hikmethankolay/Timur-RV32IMC/sw/runtime/include/timur_runtime.h

/**
 * @file timur_runtime.h
 * @brief Internal interface between the parts of the Timur C runtime.
 *
 * Shared by syscalls.c, uart.c, trap.c, vga.c and vga_font.c; programs
 * include timur.h instead. Declares the newlib system-call stubs (so that each
 * has one prototype), the linker-script symbols and the C trap entry point.
 */
#ifndef TIMUR_RUNTIME_H
#define TIMUR_RUNTIME_H

#include <stddef.h>
#include <sys/stat.h>

#include "timur.h"

/* ---- Symbols of linker.ld ------------------------------------------------------------- */
extern char _end[];       /**< first byte after .bss: the start of the heap */
extern char _heap_end[];  /**< end of the heap: the lowest address of the stack region */
extern char _stack_top[]; /**< initial stack pointer: the end of RAM */

/* ---- File descriptors of the console (<unistd.h> cannot be included: its
 *      prototypes of the stubs below differ from newlib's reentrant ones) ------------------ */
#define TIMUR_FD_STDIN  0
#define TIMUR_FD_STDOUT 1
#define TIMUR_FD_STDERR 2

/* ---- newlib system-call stubs (syscalls.c) ----------------------------------------------
 * The console is the UART: fd 0 is stdin, 1 and 2 are stdout and stderr. Errors
 * set errno and return -1, as newlib expects.                                     */
int _read(int fd, char *buf, int len);
int _write(int fd, const char *buf, int len);
void _exit(int code) __attribute__((noreturn));
void *_sbrk(ptrdiff_t increment);
int _close(int fd);
int _lseek(int fd, int offset, int whence);
int _fstat(int fd, struct stat *st);
int _isatty(int fd);
int _kill(int pid, int sig);
int _getpid(void);

/* ---- Console ------------------------------------------------------------------------------ */
/** Called by _write for every byte of stdout and stderr after the UART has sent it;
 *  vga_console_init sets it to vga_putc. NULL: the UART only. */
extern void (*timur_console_hook)(char c);

/* ---- VGA font (vga_font.c, generated by sw/gen_font.py) ------------------------------ */
#define VGA_FONT_FIRST  0x20 /**< the first character in the font */
#define VGA_FONT_GLYPHS 95   /**< 0x20-0x7E */
#define VGA_FONT_ROWS   8
/** Row r of character c is vga_font[c - VGA_FONT_FIRST][r]; bit 7 is the leftmost pixel. */
extern const uint8_t vga_font[VGA_FONT_GLYPHS][VGA_FONT_ROWS];

/* ---- Traps ---------------------------------------------------------------------------- */
/** Dispatch a trap (trap.c); called by trap_entry with the saved registers. */
void timur_trap(struct trap_frame *frame);

#endif /* TIMUR_RUNTIME_H */
