hikmethankolay/Timur-RV32IMC/(commit log)

2026-04-21 Add detailed README documentation
    Replace placeholder README with a comprehensive project README describing the Timur-RV32IMC soft-core: overview, architecture diagram, ISA support and phase status, module breakdown (primitives and execution datapath), AHB/APB bus address maps, pipeline and hazard handling, peripherals (GPIO, UART, DMAC), toolchain and build/simulation instructions, C software layer and example build steps, project roadmap, directory layout, and license. This provides full developer-facing documentation to guide development, simulation, synthesis, and software integration for the Intel FPGA target.
2026-04-21 Fix test vector file paths in testbenches
    Corrected incorrect "tb/tb/vectors/..." paths to "tb/vectors/..." in multiple testbenches so $fopen can locate the vector files during simulation. Files updated: tb/adder_32bit_tb.v, tb/alu_tb.v, tb/barrel_shifter_tb.v, tb/branch_condition_evaluator_tb.v, tb/d_ff_tb.v, tb/divider_tb.v, tb/multiplier_tb.v, tb/mux2_tb.v, and tb/mux4_tb.v. This prevents file-open errors and failing simulations.
    [adder_32bit_tb.v, alu_tb.v, barrel_shifter_tb.v, branch_condition_evaluator_tb.v, d_ff_tb.v, divider_tb.v, multiplier_tb.v, mux2_tb.v]
2026-04-21 Expand README with phases, modules and formatting
    Add detailed Phase 3–12 documentation and expand module listings across the README: PC, register file, ROM/RAM AHB slaves; decode/control/imm/parser; single-cycle integration; pipeline registers; hazard resolution and forwarding; APB peripherals (GPIO, UART, DMAC, ahb2apb bridge); AHB bus fabric (arbiter, masters, decoder); CSR regfile and C-extension decompressor; and the C software layer (linker, crt0, syscalls, bin2mif). Also reformat ASCII diagrams into fenced text blocks, tweak pipeline and bus wording/spacing, and ensure EOF newline. These changes improve roadmap clarity and document new RTL/software components added in later project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
2026-04-21 Normalize Markdown table separators in README
    Standardize the table divider rows in README.md by normalizing dash counts and spacing across multiple tables (ISA Support, Phase table, AHB/APB address maps, stall table, Tool Stack). This is a purely formatting change to improve consistency and Markdown rendering; no semantic content was modified.
2026-04-21 Add PC register module with testbench and vectors
    Add a 32-bit program counter module (rtl/memory/pc.v) that instantiates a parameterized d_ff to capture pc_next with clk, rst_n and en control signals and exposes the pc output. Introduce a Verilog testbench (tb/pc_tb.v) that reads tb/vectors/pc_vectors.txt and verifies async reset, enable-hold, clocked capture, sequential increments and jump behavior; the testbench reports pass/fail counts. The vectors file documents test cases and the check type (async vs clocked).
    [pc.v, pc_tb.v]
2026-04-21 Add AHB ROM, testbench, and memory init files
    Introduce a read-only AHB ROM peripheral and associated test infrastructure. Adds rtl/memory/rom_ahb.v (AHB slave ROM with 1Kx32 storage, addr register, ram_init attribute and $readmemh), rom.mif and ram.mif memory initialization files, a directed testbench tb/rom_ahb_tb.v, and test vector file tb/vectors/rom_ahb_vectors.txt. Also updates Quartus project files (Timur_RV32IMC.qsf and .tcl) to include the new RTL and testbench files and to add partition-related assignments. The ROM test program (rom.mif) contains sample instructions to exercise arithmetic, logic, memory, branch and multiply paths; the testbench stamps known words into ROM and verif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
2026-04-22 README: rename modules and expand simulation
    Update documentation to reflect renamed RTL modules and to provide a clearer, automated simulation workflow. Renamed references: dff -> d_ff, pll_wrapper -> cpu_pll (notes cpu_pll_bb.v black-box), adder -> adder_32bit, branch_eval -> branch_condition_evaluator, and register_file -> registers. Reworked Simulation section to describe ModelSim-Intel prerequisites, introduce run_tests.bat and the regression TCL flow, show a concise vsim/vlog example for manual runs, and document testbench conventions (vector files, total/failed counters, PASSED/FAILED output and a small settle delay for combinational checks). These changes align README text with the r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
2026-04-23 Add AHB RAM and testbench; expand ROM
    Add a new ram_ahb module (single-cycle AHB RAM) implementing address registration, byte/half/word byte-enable writes, sign/zero-extended reads, and initialization attribute for a RAM init file. Add ram_ahb_tb.v with comprehensive read/write tests (byte/half/word, LB/LBU/LH/LHU, HSEL/HTRANS behavior, async reset cases) to validate the RAM. Update rom_ahb.v to increase memory depth from 1024 to 16384 entries and change address indexing (addr_reg[11:2] -> addr_reg[15:2]) so ROM/ram use the same 16-bit word index, and adjust the initialization loop accordingly.
    [ram_ahb.v, ram_ahb_tb.v, rom_ahb.v]
2026-04-23 Tidy README and initialize ROM with NOPs
    Escape ampersand in README headings, expand the Simulation TOC with subsections (prereqs, running tests, single testbench, conventions), and mark Phase 3 as completed. In rtl/memory/rom_ahb.v initialize ROM contents to 32'h00000013 (NOP) in the initial loop and remove the $readmemh("rom.hex", mem) dependency to avoid relying on an external hex file during startup.
    [rom_ahb.v]
2026-04-23 Mark state & memory as complete in README
    Update the project roadmap in README.md: mark item 3 (State & memory — PC, Register File, ROM AHB slave, RAM AHB slave) as complete and tweak item 4's status label to '🔜 Next' for clarity.
2026-04-24 Add imm_gen immediate generator and tests
    Introduce imm_gen Verilog module that extracts and assembles 32-bit immediates for RISC-V instruction formats (I, S, B, U, J and SYSTEM), including sign-extension and zero-extension for CSR uimm. Add a regression testbench imm_gen_tb.v and a vectors file imm_gen_vectors.txt covering ALU-imm, loads, stores, branches, LUI/AUIPC, JAL/JALR and SYSTEM cases to validate sign-extension and bit-field recombination. This provides a standalone immediate-generation unit and automated vectors to catch encoding/layout issues.
    [imm_gen.v, imm_gen_tb.v]
2026-04-24 Implement SLTU and refactor ALU control mapping
    Add SLTU support and tidy up ALU internals: include SLTU in do_sub logic, add sltu_result = {31'b0, ~adder_cout}, and add an explicit case for 5'b01100 in the result mux. Reformat and group wire/reg declarations, annotate ALUControl cases with operation comments, and normalize spacing/formatting. Also changed the barrel shifter default shift_type from 2'b11 to 2'b00 (was previously the default), and made minor stylistic changes to instantiation and signal declarations. These changes implement unsigned less-than and improve readability/maintainability of the ALU module.
2026-04-24 Add SLTU and DIV/REM cases to ALU vectors
    Expand and reorganize ALU test vectors: update header/format comments, add ALUControl entries for SLTU (12) and DIV/DIVU/REM/REMU (20-23), and include new test rows covering unsigned comparisons, boundary cases, M-extension (mul) examples, division/remainder semantics, div-by-zero and signed overflow cases. Clarify adder behavior and mark SLT as signed; reorganize sections for readability and add more edge-case coverage.
2026-04-24 Add CPU datapath and module wiring to top
    Populate top-level Timur_RV32IMC with CPU datapath wiring and module instantiations. Adds PC, ROM AHB fetch, instruction parser, immediate generator, main control unit, ALU decoder, register file, ALU, branch evaluator, RAM AHB data memory, muxes and adders, plus AHB bus signals and HSEL logic. Includes temporary placeholders for enable/HTRANS/div_start and wires up pc_next selection (pc+4 vs branch target) and memory-to-register writeback.
2026-04-24 Update QSF, remove memory inits, fix top ports
    Set project TOP_LEVEL_ENTITY to Timur_RV32IMC and add multiple VERILOG_FILE entries and partition assignment in the .qsf. Remove initial-block memory zeroing from ram_ahb.v and rom_ahb.v so memories rely on their .mif initialization. Adjust top-level instance wiring in Timur_RV32IMC.v: rename register instance ports (rd_addr->rd, rd_data->reg_write_data) to match module interface and connect RegWrite accordingly, and pass rst_n into the alu. Also minor formatting/spacing fixes.
    [Timur_RV32IMC.v, ram_ahb.v, rom_ahb.v]
2026-04-24 Add MIF files & fix divider counter width
    QSF: add partition hierarchy instance assignment, include ROM/RAM MIF files, and add SOURCE_FILE db/Timur_RV32IMC.cmp.rdb. Divider: make bit_counter references explicit 6-bit literals (6'd31, 6'd0, 6'd1), ensure remainder_reg is updated in both branches, and clean up alignment/formatting. These changes prevent width/typing issues in the divider state machine and add required memory initialization files to the project file.
    [divider.v]
2026-04-24 Split datapath into module, add PLL and SDC
    Refactor top-level: move CPU datapath logic from rtl/top/Timur_RV32IMC.v into a new rtl/top/datapath.v module and simplify the top module to a wrapper that instantiates cpu_pll and the datapath (holds CPU in reset until PLL locks, exposes pc_out).
    Add timing constraints: new Timur_RV32IMC.sdc creates a 50 MHz clock, derives PLL clocks and applies standard clock uncertainty, and update the .qsf to reference the SDC and the new datapath.v file (and adjust instance/assignment ordering).
    Memory image updates: enlarge rom.mif and ram.mif to 16384 words (64 KB), initialize RAM to zeros across the full range and set ROM to NOP-filled default (previous t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
    [Timur_RV32IMC.v, datapath.v]
2026-04-24 Use byte-wide RAM banks and support byte writes
    Replace single 32-bit memory array with four 8-bit banks (mem0..mem3) and update write/read logic to perform per-byte writes using byte_enable and reconstruct 32-bit words from the byte arrays. Removed the ram_init_file attribute and made minor formatting/style cleanups. This change enables proper byte-enable writes (and may improve synthesis for byte-granular RAM accesses) while preserving existing read sign/zero-extension behavior.
    [ram_ahb.v]
2026-04-25 Fix AHB data-phase timing and add testbench
    Ensure AHB-lite timing and add simulation/testbench updates:
    - rtl/memory/ram_ahb.v: Tighten HADDR/HWRITE update to only occur when 'active' is asserted; set hsel_reg to 1 only during active and 0 otherwise. This avoids spurious selections outside an active transfer.
    - rtl/top/datapath.v: Register write-data (rs2_data) into hwdata_d and drive HWDATA from that register so write data is valid in the AHB data phase. Use pc_next for ROM HADDR/HSEL so address register matches PC after the posedge.
    - run_tests.tcl: Exclude black-box stubs and the Altera PLL megafunction from the automatic RTL glob, explicitly add the simulation-safe cpu_pll_bb.v stub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
    [datapath.v, ram_ahb.v]
2026-04-25 Fix LUI handling and bus HREADY multiplexing
    Set ALUOp to ADD for the LUI path and adjust datapath so LUI produces imm: add an AUIPC premux (pc as ALU A) and a LUI mux that forces ALU A = 0. Split HREADY into HREADY_ROM/HREADY_RAM and mux into a single HREADY based on HSEL to route per-slave ready signals. Update test vectors to reflect the corrected LUI control signals.
    [datapath.v, main_control_unit.v]
2026-04-25 Refactor datapath into pipeline stages
    Split the monolithic datapath into separate pipeline stage modules (if_stage, id_stage, ex_stage, mem_stage, wb_stage). Extracted instruction fetch, decode, execute, memory and writeback logic into rtl/top/*.v, moved ROM/RAM AHB handling into if_stage/mem_stage, and rewired pc_current/pc_plus4/pc_next, instruction, and reg-write paths between stages. The main control and ALU decoder remain in datapath while the dataflow and ALU/branch/PC logic were relocated to the new stage modules to improve modularity and prepare for further pipeline enhancements.
2026-04-26 Register new Verilog files and sync ram_ahb read
    Add multiple VERILOG_FILE entries to the Quartus project (.qsf and .tcl) to include testbenches and top-level RTL (wb/mem/if/id/ex stages, datapath, decode blocks, ram_ahb, etc.) and add a SOURCE_FILE DB entry; remove TOP_LEVEL_ENTITY 'alu' in the Tcl assignments. Modify rtl/memory/ram_ahb.v to replace the combinational 32-bit 'word' wire with a registered 'word' updated on HCLK when active and using HADDR for indexing, making RAM reads synchronous to the clock (avoids combinational-read timing/glitch issues).
    [ram_ahb.v]
2026-04-26 Use addr_reg word in RAM; fix TB reg path
    Replace the clocked 32-bit 'word' register in rtl/memory/ram_ahb.v with a combinational wire assembled from mem3..mem0 indexed by addr_reg[15:2], removing dependence on HADDR/active and simplifying byte selection. Update tb/Timur_RV32IMC_tb.v to reference the new register-file path (dut.cpu.decode.register_file.regs[]) instead of the old dut.cpu.register_memory.regs[] in both the runtime display and final checks.
    [ram_ahb.v]
2026-04-26 Use registered word in ram_ahb
    Assemble the 32-bit word from mem0..mem3 into a clocked register (word_reg) on the HCLK rising edge instead of a combinational wire. Update byte/half selection and hrdata cases to use word_reg. This makes memory reads synchronous and reduces combinational paths through the memory outputs.
2026-04-26 Add pipeline registers & refactor datapath
    Introduce explicit pipeline register modules (if_id_reg, id_ex_reg, ex_mem_reg, mem_wb_reg) and wire them into the datapath to implement IF/ID, ID/EX, EX/MEM and MEM/WB stages. Refactor datapath.v to use the new inter-stage signals, adjust stage interfaces (ex_stage now exposes jump/branch targets and redirect signal, if_stage provides pc_instr), and add a PC selection mux for next PC. Fix AHB memory slaves: ram_ahb byte/halfword byte-enable and read formatting were corrected and HRDATA is now gated; rom_ahb had minor cleanup and addr_reg placement adjusted. Update if_stage timing (pc_instr register) and adapt the testbench to observe the new IF sig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
    [datapath.v, ex_mem_reg.v, ex_stage.v, id_ex_reg.v, if_id_reg.v, mem_wb_reg.v, ram_ahb.v, rom_ahb.v]
2026-04-26 Update AHB RAM, pipeline regs, and project files
    Add pipeline register sources to project files and remove the Quartus workspace; update generated Tcl timestamp. In rtl/memory/ram_ahb.v: constrain RAM arrays to M10K, simplify and correct address/byte-enable logic, move to synchronous byte reads, use HADDR for current-phase accesses, and always drive HRDATA/HREADY/HRESP (improves timing/resource mapping and read/write behavior). In rtl/pipeline/id_ex_reg.v and rtl/pipeline/ex_mem_reg.v: separate reset and flush handling so reset explicitly zeroes all outputs and flush still clears pipeline registers, making reset semantics explicit and safer.
    [ex_mem_reg.v, id_ex_reg.v, ram_ahb.v]
2026-04-26 Pipeline AHB RAM/ROM and CPU LSU formatting
    Introduce cycle-accurate address/data-phase handling for AHB memories and move LSU formatting into the CPU. Key changes:
    - Project files: enable TIMING_ANALYZER_MULTICORNER_ANALYSIS and set NUM_PARALLEL_PROCESSORS=16 in .qsf/.tcl.
    - ram_ahb.v: switch to block/romstyle attributes, add address-phase latching, byte-enable generation function, synchronous write port using latched signals, and synchronous read pipeline returning aligned 32-bit words on the data phase.
    - rom_ahb.v: infer initialized block ROM, pipeline reads so HRDATA is the aligned 32-bit word available in the data phase.
    - mem_stage.v: capture addr LSB and funct3 in address phase and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
2026-04-26 Add stall support and IF-stage flush handling
    Introduce a stall input to the datapath and wire it from the top module (currently tied low). Propagate stall to IF/ID and ID/EX pipeline registers (use ~stall for their enable). Add pc_en and if_flush ports to if_stage so the PC can be frozen on stall and pc_instr can be flushed on branch redirects. Implement a pc_instr pipeline register that is cleared on if_flush and frozen when pc_en is low to match AHB ROM latency. Add a one-cycle delayed ex_pc_redirect_d signal and widen IF/ID flush to ex_pc_redirect | ex_pc_redirect_d to ensure correct pipeline flushing on branch redirects.
    [Timur_RV32IMC.v, datapath.v]
2026-04-26 Mark Phase 6 pipeline as complete in README
    Update project status to reflect completion of Phase 6 (5-stage pipeline registers). Adjust the status table and progress-summary lines to mark Phase 6 as ✅ Complete and move the "Next" indicator to Phase 7. This change only updates README documentation.
2026-04-27 Add forwarding and hazard units and tests
    Introduce data-forwarding and hazard detection to handle pipeline hazards and AHB bus stalls. Added new modules rtl/hazard/forwarding_unit.v and rtl/hazard/hazard_detection_unit.v and wired them into the datapath: datapath.v now instantiates forwarding_unit and hazard_detection_unit, connects HREADY signals, and uses a branch_flush signal for pipeline flushes. ex_stage.v updated to support forwarding muxes, divider start/inflight handling, refined ALU operand selection (LUI/AUIPC/JAL/JALR), and produce correct jump/branch outputs. main_control_unit.v updated to set Branch for JAL/JALR. if_stage.v and mem_stage.v updated for HREADY signals. Testbench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
    [Timur_RV32IMC.v, asm.py, datapath.v, ex_stage.v, forwarding_unit.v, forwarding_unit_tb.v, hazard_detection_unit.v, hazard_detection_unit_tb.v]
2026-04-27 Fix ALU decode, hazards and pipeline stall logic
    Multiple fixes to pipeline control, ALU decoding and testbench:
    - alu_decoder: accept opcode and only use funct7 for R-type and I-shift forms (prevents funct7 bits from leaking into I-arith like ADDI). Adjusted control logic accordingly.
    - Testbench/vectors: updated alu_decoder_tb and vector file to include opcode in vectors and cover I-arith cases.
    - registers: add write-back bypass so reads in the same cycle return rd_data when appropriate (fix RAW timing).
    - hazard_detection_unit: split stall into bubble_stall (load-use, bus-wait) and freeze_stall (multi-cycle EX like DIV); provide aggregate stall signal.
    - datapath: propagate new stall cl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
    [alu_decoder.v, alu_decoder_tb.v, datapath.v, ex_mem_reg.v, ex_stage.v, hazard_detection_unit.v, mem_wb_reg.v, registers.v]
2026-04-27 Remove tools/asm.py and tools/test_program.py
    Delete the tiny RV32IM encoder (tools/asm.py) and the test ROM generator (tools/test_program.py) used to build test_rom.hex and print expected testbench state. These files appear to be obsolete or relocated, so the testbench assembly generator and example program were removed to clean up the repository.
2026-04-27 ram_ahb write-forwarding; remove mem_read_data
    Add write-forwarding to ram_ahb so a synchronous read in the same cycle as a write returns the newly written bytes (per-byte via write_be). Remove the mem_read_data signal from the MEM/WB pipeline register because the AHB-Lite RAM has a 1-cycle synchronous read whose internal flop naturally forms the MEM/WB boundary; mem_read_data is fed directly from the MEM-stage RAM into WB. Update datapath to stop threading load data through mem_wb_reg and wire mem_read_data into the WB stage. Also make ROM HTRANS driven by pc_en in if_stage. Add explanatory comments in mem_wb_reg and datapath about the synchronous-read behavior.
2026-04-27 Migrate to SystemVerilog and add pipeline_pkg
    Add pipeline_pkg.sv (id_decoded_t) and refactor ID/IF stages into SystemVerilog modules. Rename several top modules from .v to .sv (datapath, ex_stage, mem_stage, wb_stage, Timur_RV32IMC) and replace id_stage.v/if_stage.v with fuller SystemVerilog implementations that pack/unpack the new id_decoded_t bundle. Update datapath to import the package, use the bundled ID outputs, adjust branch/flush signaling and forwarding interfaces, and move pc_plus4 calculation into ex_stage. Update run_tests.tcl to compile .sv files, enable -sv, add +incdir for packages, hoist the package file to compile first, and include the cpu_pll stub. Minor cleanup: remove o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
    [datapath.sv, mem_wb_reg.v]
2026-04-27 Update README target FPGA to DE10-Lite
    Replace references to the DE1-SoC (Cyclone V) with the Terasic DE10-Lite (Intel MAX 10 10M50DAF484C7G, 50K LEs) in the README's target FPGA and supported board list. Note that Quartus Prime remains the synthesis tool.
2026-04-27 Update Quartus project and AHB RAM/ROM RTL
    Add and reorganize project file entries (QSF/TCL): enable multicorner timing, increase parallel workers, and register many new VERILOG/SYSTEMVERILOG and testbench files (reorder/remove duplicates). Update ram_ahb.v to target M9K block RAMs, restructure synchronous read/write logic, add per-byte synchronous writes and a read-after-write bypass path so read data reflects recent writes, and rename internal read signal. Update rom_ahb.v attribute to infer M9K RAMs (replace romstyle/ram_init hint) while keeping existing initialization via $readmemh. Also update generated Tcl timestamp.
    [ram_ahb.v, rom_ahb.v]
2026-04-27 Simplify multiplier logic and use DSP
    Replace multiple sign/unsigned extensions and product wires plus a mux with a single signed multiply. Add a_is_signed and b_is_signed signals to compute 33-bit extended operands, use a single (* multstyle = "dsp" *) product, and select either the low 32 bits for MUL or the high 32 bits for MULH variants. This reduces duplicated logic, removes the external mux4 instance, and guides synthesis to use DSP resources.
    [multiplier.v]
2026-04-28 Add 2-cycle pipelined multiplier and integrate MUL
    Introduce a 2-cycle pipelined multiplier module and wire MUL support through the datapath and hazard logic. The multiplier registers DSP inputs, produces a busy/done handshake, and returns 32-bit results; alu, ex_stage and hazard_detection_unit were extended to support mul_start/mul_busy/mul_done and to prevent restarts while a MUL is inflight. ID stage now precomputes PC+4 and branch target (moved out of EX) and the ID/EX register carries these values. registers.v was changed to write on negedge and provide combinational reads (x0 hardwired), removing previous bypass muxes. wb_stage simplified memory-to-reg selection to use alu_result direc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
    [alu.v, alu_tb.v, datapath.sv, hazard_detection_unit.v, hazard_detection_unit_tb.v, id_ex_reg.v, multiplier.v, multiplier_tb.v]
2026-04-28 Set board clk period to 25 ns
    Update SDC to use a 25 ns clock period by changing create_clock from 20.000 to 25 and updating the inline comment. This adjusts the implied oscillator from 50 MHz (20 ns) to 40 MHz (25 ns); derive_pll_clocks is unchanged.
2026-04-29 Clean up comments in execution RTL
    Remove and simplify non-functional comments in the execution stage sources: shorten the SLTU comment in rtl/execution/alu.v and delete the large header comment block in rtl/execution/multiplier.v. These are documentation-only edits and do not change logic or behavior.
    [alu.v, multiplier.v]
2026-04-29 Refactor branch/jump handling and cleanups
    Simplify and consolidate branch/jump logic across IF/ID/EX and datapath, remove unused signals and extraneous comments. Key changes:
    - ex_stage: remove Branch input, introduce OPC_BRANCH and is_cond_branch/is_uncond_jump signals; simplify ALU A selection (replace mux with combinational assign); evaluate conditional branches into cond_branch_taken and compute redirect_pc (JALR vs B/JAL); emit branch_target_out and BranchTaken_out from EX based on masked conditional branch or unconditional jumps; remove jump_target wire and related mux.
    - datapath: drop unused ex_jump_target and related ports; remove various explanatory comments and dead wiring; pass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
    [datapath.sv]
2026-04-29 Refactor pipeline regs and decode bus names
    Rework pipeline package and pipeline registers to a clearer, gated/flushable interface for multicycle backend support. Renamed id_decoded_t → dec_bus_t and many fields (opcode→opc7, rd→rd_idx, rs1/rs2→rs1_idx/rs2_idx, imm→imm32, ALUControl→alu_ctrl5, ALUSrc→alu_use_imm, etc.). Updated IF/ID, ID/EX, EX/MEM and MEM/WB modules to use gate_i/flush_i semantics, new signal suffixes (_d/_x/_m/_w), and added control signals (wb_from_ld, rf_we, br_jmp, csr/trap fields). Top-level and datapath were adjusted for new clock/PLL naming, PC debug export, and the revamped pipeline interfaces; forwarding and hazard units were re-wired to the new signa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
    [datapath.sv, ex_mem_reg.v, id_ex_reg.v, if_id_reg.v, mem_wb_reg.v]
2026-04-29 Fix board clock port/name and comment
    Update SDC to match the top-level RTL: change the create_clock name from {clk} to {clk_board} and the port from {clk} to {clk_i}. Also correct the file comment to state 40 MHz (25 ns period) and make the period explicit as 25.0. This ensures the SDC clock declaration matches Timur_RV32IMC.sv and fixes the previous misleading frequency comment.
2026-04-29 Make multiplier combinational single-cycle
    Replace the 2-cycle/pipelined multiplier with a single-cycle combinational implementation and remove associated control signals. The multiplier now sign/zero-extends operands to 33 bits, uses a combinational DSP-style product, and directly drives the 32-bit result (MUL selects low 32, MULH/MULHSU/MULHU select high 32). ALU and EX-stage interfaces were simplified by removing mul_start/mul_busy/mul_done, and hazard detection/datapath were updated to treat MUL as a single-cycle op (only DIV remains multi-cycle). Testbenches for ALU, multiplier, and the hazard unit were adjusted to remove start/busy/done sequencing for MUL and to use the single-cycle be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
    [alu.v, alu_tb.v, datapath.sv, hazard_detection_unit.v, hazard_detection_unit_tb.v, multiplier.v, multiplier_tb.v]
2026-04-29 Add APB GPIO peripheral module
    Add rtl/peripherals/gpio_apb.v implementing a simple APB slave GPIO peripheral and remove .gitkeep. The module provides 32-bit GPIO OUT (0x00), IN (0x04) and DIR (0x08) registers, with OUT/DIR writable via APB (PSEL/PENABLE/PWRITE) and IN sampled through a two-stage synchronizer to avoid metastability. PREADY is tied high and PSLVERR low; reset clears registers to zero. No byte-enable or wait-state support is implemented in this basic peripheral.
    [gpio_apb.v]
2026-04-30 Add DE10-Lite pinout and clock updates
    Add Terasic DE10-Lite board pin assignments and SDC clock setup, update top-level ports to use board clocks, and adapt testbench. QSF: reference SDC, device filter and large set of IO location/IO_STANDARD assignments generated by System Builder. SDC: create board clocks (10 MHz and two 50 MHz) and placeholders for derived/uncertainty constraints. rtl/top/Timur_RV32IMC.sv: replace single clk port with ADC_CLK_10, MAX10_CLK1_50 and MAX10_CLK2_50 and feed PLL from MAX10_CLK1_50. tb/Timur_RV32IMC_tb.v: add clk_50/clk_10, toggle matching periods, force PLL locked and cpu clock from 50 MHz, and update DUT port connections to match the new top ports. These cha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
2026-04-30 Revert "Make multiplier combinational single-cycle"
    This reverts commit 6d274d9fe834fa853eb9d34bcd238e47f1628827.
    [alu.v, alu_tb.v, datapath.sv, hazard_detection_unit.v, hazard_detection_unit_tb.v, multiplier.v, multiplier_tb.v]
2026-04-30 Add adder_zero signal from ALU
    Introduce a new adder_zero output from the ALU that reflects whether the adder output == 0, distinct from the full muxed ALU result zero. Propagate this signal through ex_stage (added adder_zero_w and connected it to the branch_condition_evaluator) and update the ALU testbench to include the new port. This avoids using the wide muxed result for branch comparisons (BEQ/BNE) and keeps branch logic tied to the adder output.
    [alu.v, alu_tb.v]
2026-04-30 Compute aligned JALR target via adder
    Instantiate a dedicated 32-bit adder to compute rs1 + imm for JALR, generate jalr_sum_w and jalr_pc_w (LSB forced to 0), and wire unused cout/overflow outputs to avoid warnings. Replace the previous use of alu_raw_w for JALR jump target with jalr_pc_w so jmp_pc_w is correctly aligned. Changes in rtl/top/ex_stage.sv.
2026-04-30 Add ALU-A ID-side operand for AUIPC/LUI
    Propagate an ID-side ALU-A operand so LUI/AUIPC can use a precomputed A input. Added alu_a_use_id and alu_a_id to pipeline_pkg, latched them in id_ex_reg, and wired them through datapath to the EX stage. id_stage now accepts pc_d_i and sets dec_bus.alu_a_use_id/alu_a_id (AUIPC uses PC, LUI uses 0). ex_stage signature updated to consume the new signals and removed the now-unused pc_x_i port. Files changed: rtl/include/pipeline_pkg.sv, rtl/pipeline/id_ex_reg.v, rtl/top/datapath.sv, rtl/top/ex_stage.sv, rtl/top/id_stage.sv.
2026-04-30 Split barrel_shifter into SLL/SRL/SRA paths
    Refactor barrel_shifter to implement three separate 32-bit logarithmic shift trees (SLL, SRL, SRA) with per-stage 2:1 muxes, and a final 4:1 type mux to select the shift type or bypass to the original input. Preserves arithmetic right-shift sign extension from the original input MSB (matching prior behavior), and maintains the bypass behavior for shift_type == 2'b11. This clarifies the shift logic and removes the previous per-stage type multiplexing.
2026-04-30 Mark Phase 7 complete; clarify hazard handling
    Update README to mark Phase 7 as complete and move Phase 8 to “next”. Expand the Hazard Detection Unit docs to describe multi-cycle ALU ops (div/mul), introduce bubble_stall vs freeze_stall semantics, and add mul_busy handling. Clarify that branch/jump redirect is committed in MEM (br_jmp ∧ br_taken) and adjust the hazard table and pipeline behavior explanations accordingly.
2026-05-01 Add UART APB peripheral and testbench
    Introduce a simple UART APB peripheral and supporting RTL: uart_apb, uart_apb_regs, uart_baud_gen, uart_tx and uart_rx. Add a loopback testbench (tb/uart_apb_tb.v) that configures a baud divisor and verifies TX->RX loopback for values 0x41, 0x00 and 0xFF. Update Timur_RV32IMC.qsf to include the new UART sources and tweak run_tests.tcl to recursively collect RTL files from deeper subdirectories.
    The APB register interface provides DATA (0x00), STATUS (0x04) and CTRL (0x08) registers, handling transmit start, baud divisor programming, and RX read strobes. The baud generator produces a tick from a 16-bit divisor; TX/RX implement an 8N1 serializer/deseriali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
2026-05-01 Add APB DMAC peripheral and testbench
    Introduce a simple APB-accessible DMA controller (rtl/peripherals/dmac_apb.v) with SRC/DST/LEN registers, a CTRL register that pulses dma_start when writing bit0 while not busy, and a STATUS register exposing dma_busy/dma_done. APB signals PREADY/PSLVERR are tied to ready/no-error; PRDATA multiplexes register reads. Add a comprehensive testbench (tb/dmac_apb_tb.v) that verifies register readback, single-cycle start pulse behavior, busy-guarding of start, and STATUS bit reporting. This adds basic DMA control infrastructure and validation scaffolding for integration.
2026-05-01 Add AHB-to-APB bridge and testbench
    Add a simple ahb2apb_bridge RTL module and a comprehensive testbench. The bridge implements a 4-state FSM (IDLE, SETUP, ACCESS, COMPLETE), latches AHB address/write/data, decodes HADDR[9:8] to select uart/gpio/dmac, drives APB signals (PSEL, PENABLE, PWRITE, PADDR, PWDATA), multiplexes PRDATA back to HRDATA, and respects peripheral PREADY. The testbench (ahb2apb_bridge_tb.v) exercises write/read transfers, idle transfer suppression, and PREADY wait-state behavior with pass/fail checks for expected signals.
2026-05-01 Mark Phase 8 as complete in README
    Update README status to reflect completion of Phase 8 (APB peripherals: GPIO, UART, DMAC control registers, AHB-to-APB bridge). Adjust the progress table and milestone list entries to mark Phase 8 as ✅ Complete and update the Phase 9 wording/positioning (move 'Next' indicator to Phase 9). Minor wording/arrow tweaks for clarity.
2026-05-02 Add AHB bus fabric, soc top, and core integration
    Introduce full AHB bus fabric and system integration: add ahb_arbiter, ahb_decoder, and a skeleton dmac_ahb_master plus a new soc.v top-level that wires the arbiter, decoder, ROM, RAM, AHB→APB bridge, CPU core and DMAC. Convert ROM to a dual-port M9K (separate I-fetch port A and shared D-bus port B), register address-phase HSEL in the decoder to keep HRDATA/HREADY aligned to the data phase, and add bus arbitration/muxing for CPU vs DMAC masters.
    Refactor the core and top-level wiring: rename datapath → rv32imc_core and expose separate I-fetch and D-access AHB master interfaces; update if_stage and mem_stage to drive/consume AHB signals;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
2026-05-02 Replace ASCII architecture diagram with image
    Replace the large ASCII art architecture block in README.md with an embedded Mermaid diagram image (mermaid.ink) and a clickable mermaid.live edit link. Preserves the surrounding pipeline stages and bus standard notes while improving visual clarity and maintainability.
2026-05-04 AHB decoder, rs2 forwarding, and project files
    Improve AHB decoding and pipeline store-data forwarding, and update project TCL/QSF listings.
    - rtl/bus/ahb_decoder.v: add HTRANS input and separate combinatorial address-phase HSEL outputs from registered data-phase selects; latch selects only on active transfers (HTRANS[1]); use registered selects for HRDATA/HREADY muxing to ensure correct data-phase routing.
    - rtl/top/ex_stage.sv: export rs2_fwd_x_o for forwarding the rs2 value into the store-data path.
    - rtl/top/rv32imc_core.sv: wire and route rs2_fwd_x_w from EX stage into the rs2_store_x_in port so forwarded rs2 is used for stores.
    - rtl/top/soc.v: pass HTRANS signal into the AHB decoder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
    [ahb_decoder.v, ahb_decoder_tb.v]
2026-05-04 Separate ROM into mem_a and mem_b
    Replace single mem array with mem_a and mem_b (both M9K) and initialize both from test_rom.hex. Update port A/B read logic to index the respective arrays so each AHB port reads from its own memory instance. Minor comment tweaks to reflect per-port reads.
    [rom_ahb.v]
2026-05-04 Pipeline multiplier; divider fixes; regfile bypass
    Refactor execution units and register file and update testbench.
    - divider.v: simplify RUNNING iteration by computing a 34-bit trial subtraction (shifted remainder/dividend minus divisor) and use that to set remainder and quotient; add intermediate wires and shift dividend in the loop. Minor whitespace fixes.
    - multiplier.v: convert combinational product wire into a pipelined DSP output register (product_q) and add a 3-stage flow (stage1 inputs, stage2 DSP capture, stage3 select half). Forward mul_op through mul_op_q2 and use stage-valid flags to control busy/done signaling. Keep multstyle="dsp" hint.
    - registers.v: change write port to pos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
    [divider.v, multiplier.v, registers.v, rom_ahb_tb.v]
2026-05-05 Add AHB master FSM and update testbench
    Implement a finite-state machine in dmac_ahb_master.v to drive AHB read/write transfers: new states for request/read-addr/read-data/write-addr/write-data/done, pointer/length tracking, read buffering, and generation of HBUSREQ/HTRANS/HWRITE/HADDR/HWDATA signals. Expose dmac_busy and dmac_done based on FSM state.
    Update tb/dmac_ahb_master_tb.v to support larger transfers and correct behavior: expand src/dst memories from 16 to 128 words, adjust word indexing to use addr[8:2], refine address/data-phase handling to avoid spurious writes when no address phase, update initialization loops, and remove redundant clock delays in checks.
    [dmac_ahb_master.v, dmac_ahb_master_tb.v]
2026-05-05 Add HLOCK support to DMAC AHB master
    Expose and drive HLOCK from the DMAC AHB master so the arbiter can lock the bus across a word's address phase. rtl/bus/dmac_ahb_master.v: added HLOCK output and logic to hold it during READ_ADDR/READ_DATA/WRITE_ADDR and release in S_WRITE_DATA, with explanatory comment. rtl/top/soc.v: wired dmac_HLOCK into the arbiter HLOCK vector, introduced a registered HMASTER_d used to select HWDATA from the previous master (avoids data-phase mux glitch), and connected the signal into the DMAC instance. tb/dmac_ahb_master_tb.v: added HLOCK signal to the testbench and checks to validate HLOCK is low idle, asserted during address-phase, and released at transfer completi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
    [dmac_ahb_master.v, dmac_ahb_master_tb.v]
2026-05-05 Clarify AHB arbiter/decoder/DMAC & SoC
    Expand Phase 9 documentation with precise AHB fabric behavior: describe the arbiter as a single-bit state machine that grants CPU by default and switches to DMAC only at HREADY=1 boundaries (conditions include HBUSREQ, HLOCK and HGRANT semantics), and list its outputs (HGRANT, HMASTER, HMASTLOCK). Clarify the decoder’s registered slave select so HRDATA/ HREADY stay aligned with the data phase. Detail the DMAC AHB master as a seven-state FSM that latches pointers, buffers HRDATA for writes, asserts HLOCK during address-phase states, and produces a one-cycle dmac_done pulse. Document the CPU-side AHB interface and dedicated instruction-fetch path, and u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
2026-05-05 Implement pipelined AHB master FSM for DMAC
    Replace the previous 7-state FSM with a pipelined read/write FSM that alternates read-address and write-address cycles to halve per-word latency (~2 cycles steady-state vs ~4). Introduces explicit states (S_R_ISSUE_FIRST, S_W_ISSUE, S_R_ISSUE, S_FINAL_DATA) and simplifies transitions. Rename words_left to reads_remaining and adjust pointer updates and rd_buf usage: HRDATA is captured in the write-issue data phase and HWDATA drives rd_buf during subsequent read-issue/final data phases. Update HTRANS, HWRITE, HADDR, HWDATA and HLOCK encodings to reflect the new pipeline behavior, and keep HBUSREQ/dmac_busy/dmac_done semantics. Add clarifying comments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
    [dmac_ahb_master.v]
2026-09-26 Rework pipeline, bus fabric and tests for phases 1-9
    Rewrite the RTL, testbenches and project files for phases 1-9.
    Structure
    - Verilog-2001 only. New layout: rtl/execute, rtl/state, rtl/periph,
    vectors/. soc -> timur_soc, ahb2apb_bridge -> ahb_apb_bridge,
    dmac_apb -> dmac_apb_regs. The SystemVerilog stage files and
    pipeline_pkg are removed.
    - The board wrapper holds cpu_pll, reset gating and the new
    reset_sync; timur_soc holds everything else.
    Datapath and decode (phases 2-4)
    - XOR adder, per-stage barrel shifter, single 33x33 multiplier.
    - The divider only starts when the bus is not waiting and holds done
    until the DIV leaves EX, so a done that falls into a bus freeze is
    not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
    [Timur_RV32IMC.v, adder_32bit.v, adder_32bit_tb.v, ahb_apb_bridge.v, ahb_apb_bridge_tb.v, ahb_arbiter.v, ahb_arbiter_tb.v]
2026-09-26 Meet 50 MHz timing: two-cycle MUL, faster EX redirect path
    Setup timing failed at 50 MHz (Slow 1200mV 85C slack -12.9 ns, Fmax
    30.4 MHz). The critical path ran from load data forwarded out of WB
    through the single-cycle multiplier, the ALU result mux and the zero
    flag into the branch redirect and the ROM fetch address.
    Timing:
    - multiplier: operands registered on the first EX cycle, product formed
    in the second; start/done/ack handshake like the divider
    - hazard unit: MUL joins DIV in the EX stall class (one stall cycle per
    MUL); new mul_in_ex/mul_done inputs, mul_start/mul_ack outputs
    - timur_soc: branch compare (rs1 - rs2, rs1 == rs2) and JALR target
    (rs1 + imm) use the forwarded op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
    [adder_32bit.v, ahb_decoder.v, alu.v, alu_tb.v, barrel_shifter.v, gen_soc_tests.py, hazard_detection_unit.v]
2026-09-26 Add machine mode, C extension and the C software layer
    - CSR file and trap unit: CSR accesses in EX, precise traps (illegal,
    EBREAK, ECALL, misaligned load/store), MRET, 64-bit counters, and a
    machine external interrupt from the UART receiver and the DMAC
    - RV32C: decompressor in IF, split-bank ROM so 32-bit instructions can
    sit on any halfword boundary, PC + 2 links
    - Fetch path restructured for 50 MHz: branch decision prepared for
    each compare outcome, per-address ROM indexes, keep attributes
    - C runtime: linker script, crt0, trap handler, newlib system calls,
    build script and binary-to-memory converter
    - C test programs on the SoC testbench, checked against the reference
    model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
    [bin2mem.py, branch_condition_evaluator.v, branch_condition_evaluator_tb.v, build.py, csr_file.v, csr_file_tb.v, decompressor.v]
2026-09-30 Add failing tests for the Python tool defects and the planned package API (RED)
    Runtime RED against the existing scripts (tests/host/test_cli.py, 11 failing):
    - generators fail with FileNotFoundError from any directory but the project
    root, and have no --root option
    - build.py accepts --stack-size -5, 0 and 65536 and any -O value
    - gen_sw_tests.py and run_model.py end in a traceback for a missing image or
    program; run_model.py accepts --max 0 and --cycles 0
    Compile-time RED (ModuleNotFoundError: timur_tools): test_asm.py (missing
    operands must be AsmError, not IndexError; cross-check against GNU as),
    test_model.py (fake time must not change module state), test_toolchain.py
    (one discover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
    [test_asm.py, test_cli.py, test_model.py, test_romimage.py, test_toolchain.py]
2026-09-30 Extract shared tool infrastructure into the sw/timur_tools package
    New modules: errors (TimurError), paths (Project, TIMUR_ROOT), memmap (one
    Python copy of the memory map, CSR addresses and trap causes), toolchain (one
    discovery order: argument, TIMUR_TOOLCHAIN_PREFIX, PATH, newest release in
    .tools/), romimage (word hex, banks, .mif, and one reader for tagged images),
    builder (typed BuildResult/Section instead of dicts and tuples) and cli.
    sw/bin2mem.py and sw/build.py become thin entry points with main(argv) -> int.
    build.py now validates --stack-size and -O, reports a missing linker symbol
    as an error instead of a KeyError, and passes -ffile-prefix-map so the
    checkout location does not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
    [bin2mem.py, build.py, builder.py, cli.py, errors.py, gen_soc_tests.py, gen_sw_tests.py, memmap.py]
2026-09-30 Split gen_soc_tests.py into assembler, RVC, model and generator modules
    gen_soc_tests.py (1881 lines) held the assembler, the RVC expansion, the
    reference model, nine assembly programs as strings, two random generators
    and the vector writer. Now:
    - sw/timur_tools/isa.py, asm.py, rvc.py, model.py, randprog.py, vectors.py
    - sw/programs/*.s: the directed and bring-up programs as assembly sources
    - gen_soc_tests.py, gen_sw_tests.py, run_model.py: entry points with
    main(argv), --root, and GenerationError instead of sys.exit in helpers
    Fixes: a missing assembler operand is an AsmError naming the line (was an
    IndexError); --fake-time is a model option instead of clearing a module-level
    set that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
    [asm.py, errors.py, gen_soc_tests.py, gen_sw_tests.py, isa.py, model.py, randprog.py, run_model.py]
2026-09-30 Turn the unit-vector and decompressor-vector generators into entry points
    gen_unit_vectors.py: main(argv) with --root (it only worked from the project
    root, with no options); the CSR and trap-unit inputs are frozen dataclasses
    named after the RTL ports instead of dicts; the CSR addresses, MISA and the
    trap causes come from timur_tools.memmap.
    gen_decompressor_vectors.py: the toolchain is found like everywhere else
    (--prefix still wins); failures are GenerationError/ToolchainError messages
    instead of sys.exit deep in the helpers.
    GREEN: all 92 host tests, including the working-directory and --root tests
    of test_cli.py; the golden files are unchanged.
    [gen_decompressor_vectors.py, gen_unit_vectors.py, test_asm.py, test_model.py]
2026-09-30 Test the generators, the builder and the model runner in-process
    Coverage of sw/ rises from 37% (only what the subprocess tests reach) to 98%;
    make coverage now fails below 90%.
    [test_builder.py, test_generators.py, test_vectors.py]
2026-09-30 Move the C runtime to sw/runtime and give C and assembly one set of constants
    - sw/runtime/{crt0.S,syscalls.c,trap.c,linker.ld}, headers in sw/runtime/include
    (programs keep #include "timur.h"; build.py puts the folder on the path)
    - timur_defs.h: memory map, register offsets and bits, CSR fields, trap
    causes and the trap-frame layout as plain #defines, included by crt0.S too;
    crt0.S saves and restores the frame through TRAP_FRAME_* instead of literal
    offsets, and timur.h checks struct trap_frame against them with
    _Static_assert
    - timur_runtime.h: one prototype for each newlib stub and for timur_trap
    (trap.c had copies of three of them), and the linker-script symbols
    - timur.h: D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
2026-09-30 Add failing on-target checks of the runtime's argument handling (RED)
    selftest.c gains a 'limits' section; run on the reference model
    (sw/run_model.py sw/build/selftest.elf --max 3000000) it prints:
    MISMATCH ecall write length[0]: got 80000000, expected ffffffea
    MISMATCH ecall write length[1]: got ffffffff, expected ffffffea
    MISMATCH ecall write source[0]: got 00000001, expected fffffff2
    MISMATCH ecall write source[1]: got 00000002, expected fffffff2
    and then hangs in uart_getc: an ECALL read into ROM (or a peripheral
    register) is carried out instead of rejected with -EFAULT.
    gen_sw_tests.py now builds the test programs with the runtime's warnings as
    errors; io.c fails that build (-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
    [gen_sw_tests.py, selftest.c]
2026-09-30 Validate system-call arguments, split the UART driver and the trap entry (GREEN)
    Runtime fixes (the RED checks of the previous commit now pass):
    - ECALL read/write: a length above 0x7FFFFFFF is -EINVAL; a buffer outside
    ROM or RAM (write) or outside RAM (read) is -EFAULT, checked overflow-safely;
    a read into ROM or a peripheral register used to be carried out
    - _write/_read reject a negative length with EINVAL
    - _isatty, _fstat and _lseek accept only the console (fds 0-2), else EBADF
    - _sbrk computes the magnitude in unsigned arithmetic: -increment was
    undefined for PTRDIFF_MIN
    - _start jumps to _halt should exit ever return, instead of relying on _halt
    being linked right after it
    S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
    [analyze.py, builder.py, io.c, selftest.c, timur.h, timur_runtime.h, trap.c, uart.c]
2026-09-30 Make the regression and board scripts shellcheck-clean and configurable
    run_tests.sh collects the RTL files and testbenches with globs into arrays
    instead of parsing ls, and takes the simulator from IVERILOG and VVP when
    set; program_board.sh joins the changed-file list without an unquoted echo;
    run_tests.bat takes vsim.exe from VSIM when set (default unchanged).
    All 40 testbenches pass through the rewritten run_tests.sh.
2026-09-30 Add a CI workflow and cppcheck to the static analysis
    .github/workflows/ci.yml runs make lint, typecheck, coverage, analyze and sim
    on Ubuntu with the xPack GCC release the committed images were built with
    (pinned version and SHA-256) and Icarus Verilog.
    cppcheck comes from pip (the cppcheck-wheel package), so requirements-dev.txt
    covers every analysis tool; clang-tidy and shellcheck are listed there too.
    cppcheck cannot parse GNU explicit register variables, so sw/analyze.py
    defines __asm__(x) away for it; its one finding, that exception_handler always
    returns 0, is the weak default and is suppressed with a comment. The images
    are unchanged.
2026-09-30 Document the new layout, the runtime's behaviour and the development workflow
    README: sw/runtime and its headers, sw/programs, sw/timur_tools, tests/host;
    the argument checks of the ECALL system calls and the console stubs; the
    build flags and warning policy; the hardware assumptions of the runtime; a new
    'Development and Checks' section (make targets, environment variables, the
    layout of the Python tools, the one set of hardware constants, the C coding
    rules and their deliberate deviations). selftest now has 255 checks.
    build.py: --strict builds the program's sources with the runtime's warnings
    as errors.
    [build.py, builder.py]
2026-09-30 Report a wrong toolchain prefix at once; warn about another GCC in both generators
    Review findings (silent failures):
    - TIMUR_TOOLCHAIN_PREFIX or --prefix naming no gcc was accepted and only
    failed at the first tool run, far from the cause; find_toolchain now raises
    ToolchainError naming the setting
    - gen_soc_tests.py rebuilt the GNU-assembled images (phase11, random_c) with
    any compiler without saying that another release changes them;
    warn_if_not_pinned is now shared by both generators
    Regression tests: test_toolchain.py (explicit prefix, warning) and
    test_generators.py (gen_soc_tests warns); they failed before this change.
    [gen_soc_tests.py, gen_sw_tests.py, test_generators.py, test_toolchain.py, toolchain.py]
2026-09-30 Test sw/analyze.py and pass clang-tidy its configuration explicitly
    Review findings (Python review):
    - sw/analyze.py had no tests. New tests/host/test_analyze.py plants a null
    dereference in a copy of the runtime and requires GCC -fanalyzer, clang-tidy
    and cppcheck each to report it, the clean runtime to pass, an assembler
    .warning to fail, and main() to exit 1 on any finding.
    - Those tests exposed a silent failure: clang-tidy looks for .clang-tidy next
    to the sources; without it, it failed with 'no checks enabled', which was
    counted as a finding. analyze.py now passes --config-file and stops with a
    clear error if the file is missing; the tests also check that a reported
    failur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
    [analyze.py, run_model.py, test_analyze.py, test_vectors.py]
2026-10-10 Add VGA output: 320x240 16-colour framebuffer at 640x480, driver and console
    Hardware (Phase 13):
    - rtl/periph/vga.v: 640x480 at 60 Hz, one pixel every second clock (single
    clock domain). A 320x240 framebuffer of 4-bit pixels (four 9600x8 byte
    lanes) is an AHB slave at 0x3000_0000; registers on APB at 0x4000_0300:
    CTRL, STATUS (vblank), SCROLL, FRAME and a 16-entry 12-bit palette. The
    video fetch shares the read port with AHB reads; a read that meets the
    fetch slot takes one wait state, writes never wait.
    - ahb_decoder: HSEL_VGA for 0x3000; ahb_apb_bridge: APB page 0x03.
    - timur_soc and the board wrapper: vga_r/g/b[3:0], vga_hs, vga_vs; DE10-Lite
    VGA pins in the .qsf, false paths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
2026-10-10 Add D2 and WaveDrom diagrams of the whole design to the README
    Fifteen diagrams, drawn from the RTL and the software: the SoC and its board
    pins, the memory map, the AHB fabric, AHB and APB bus timing, the five-stage
    pipeline, the split-bank ROM fetch, forwarding and hazards, the trap path,
    the UART frame, the VGA controller and its sync timing, the build flow, the
    verification flow and the run-time memory layout.
    - Sources in docs/diagrams/src (D2 for block and flow diagrams, WaveDrom
    JSON for timing), committed SVGs in docs/diagrams; _style.d2 holds the
    shared look: zinc greys, one cobalt accent for the data path, monospace
    for addresses, one corner radius.
    - whiten.py gives every S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
2026-10-10 Rework the README for first-time visitors
    - Plain-language opening, CI and license badges, and a highlights list.
    - Prerequisites with versions and tested platforms, complete installation
    (the CI's checksum-verified toolchain download), a quick start with its
    real output, and three usage examples: serial printf, printf on a VGA
    monitor, and a picture shown by DMA. All were built and run on the model.
    - A "Not supported" table of what the design leaves out.
    - Module structure, testbench conventions and vector regeneration folded
    into collapsible sections; Phase 12 now precedes Phase 13.
    - Simulation starts with make sim and Icarus; ModelSim on Windows follows.
    - Contributing and Suppo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
2026-10-10 Make the design portable to other FPGA boards
    Add a TIMUR_PORTABLE define for non-Quartus builds: the ROM loads
    rom_lo.hex and rom_hi.hex with $readmemh instead of the .mif files, and
    the ROM, RAM and framebuffer drop the Intel ramstyle = "M9K" hints,
    which Yosys obeys and cannot map on other FPGAs. The DE10-Lite build
    never defines it, so Quartus sees the same code as before.
    Add boards/template/timur_board_top.v, a board wrapper without vendor
    IP, and a README section on porting: what a board needs, the steps,
    and notes per FPGA family (Yosys: XC7A35T fits with 41 of 50 block
    RAMs; ECP5 needs a 45F or larger).
    Claude-Session: https://claude.ai/code/session_01UzWGRi4EFmqt99JE7RUTLV
2026-10-14 Mark VGA as tested on the board; add the showcase demo
    VGA (Phase 13) runs on the DE10-Lite: the design with the framebuffer
    compiles in Quartus, and apps/vga_demo.c and apps/showcase.c drive an
    external monitor at 640x480, 60 Hz with a correct picture (14 October
    2026). The resource and timing numbers are not yet re-measured with
    the framebuffer in, so that stays an open item.
    - apps/showcase.c: a tour of the design on the monitor, seven scenes
    of about ten seconds each, repeated forever: the console with
    hardware scrolling, a palette-animated plasma, a fixed-point
    Mandelbrot timed with mcycle, a rotating wireframe cube, sprites
    moved in the vertical blank, a pict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
2026-10-26 fix(model): carry timing taint through DMA copies and peripheral stores
    A DMA copy wrote its words without updating ram_taint/vram_taint, so a
    timing-dependent source word became a "clean" destination word and the
    generated checks could expect a value the RTL does not produce. A tainted
    store to an APB register (UART, GPIO, DMAC) was silently accepted, baking a
    timing-dependent value into the UART/LED expectations; it now raises
    TimingDependentError like a tainted address or branch does.
    The taint rule (a tainted write taints the word, a whole clean word cleans
    it) now lives in one helper, _write_memory, used by stores and the DMAC.
    Also cache instruction decoding (decompress, is_legal) an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
2026-10-26 fix(asm): reject duplicate labels, unaligned .org and oversized CSRs
    These were assembled silently into a wrong image: a duplicate label
    overwrote the first, .org accepted negative or unaligned addresses (and
    ".orgfoo" was taken for .org), and a CSR number above 12 bits was
    truncated. A non-ASCII digit in a register name crashed with ValueError
    instead of AsmError. Any whitespace now separates the mnemonic, and .org
    is case-insensitive like every other mnemonic.
    Claude-Session: https://claude.ai/code/session_01VQRgkJATuAi8SYVo8cYNQX
2026-10-26 fix(image): report a malformed PNG IHDR chunk as ImageError
    A header chunk of the wrong length raised struct.error, which cli.run does
    not catch, so img2vga printed a traceback instead of a one-line error.
    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
